wozniak-works/entropy/hardware/0.4-w/keyboard.kicad_sch

## KiCad design hardware/0.4-w/keyboard.kicad_sch (2022-02-18)

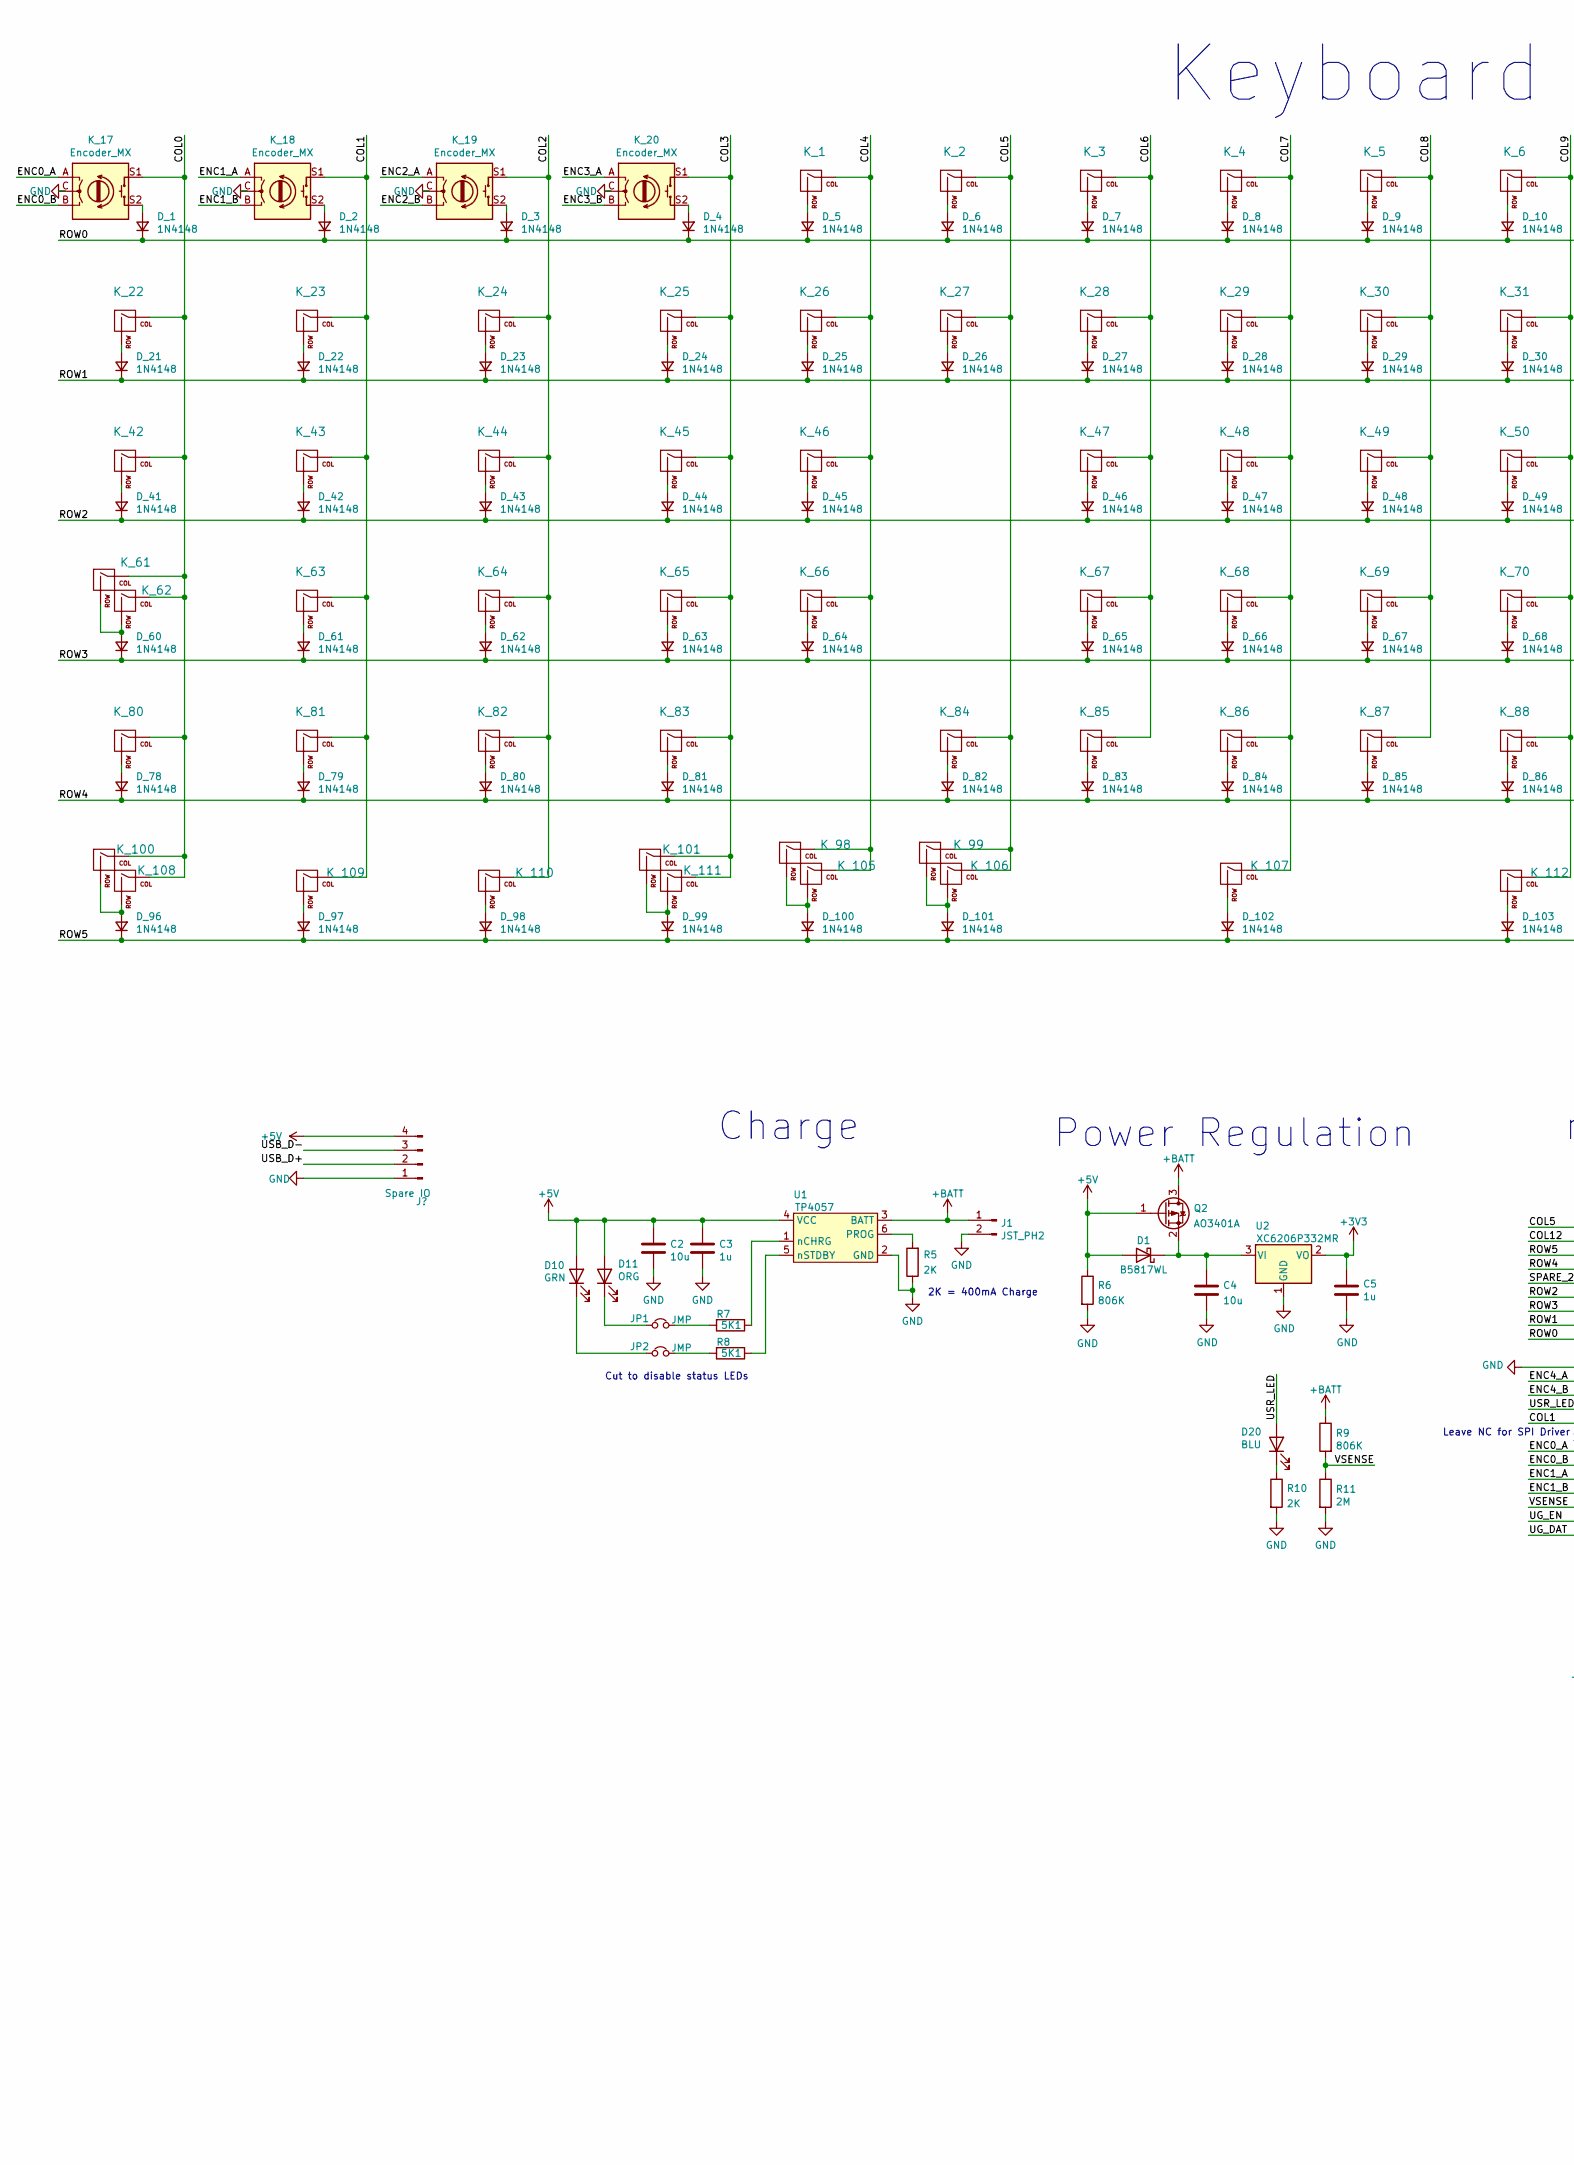
[picture p1: schematic keyboard.kicad_sch, part in row 1, column 1]

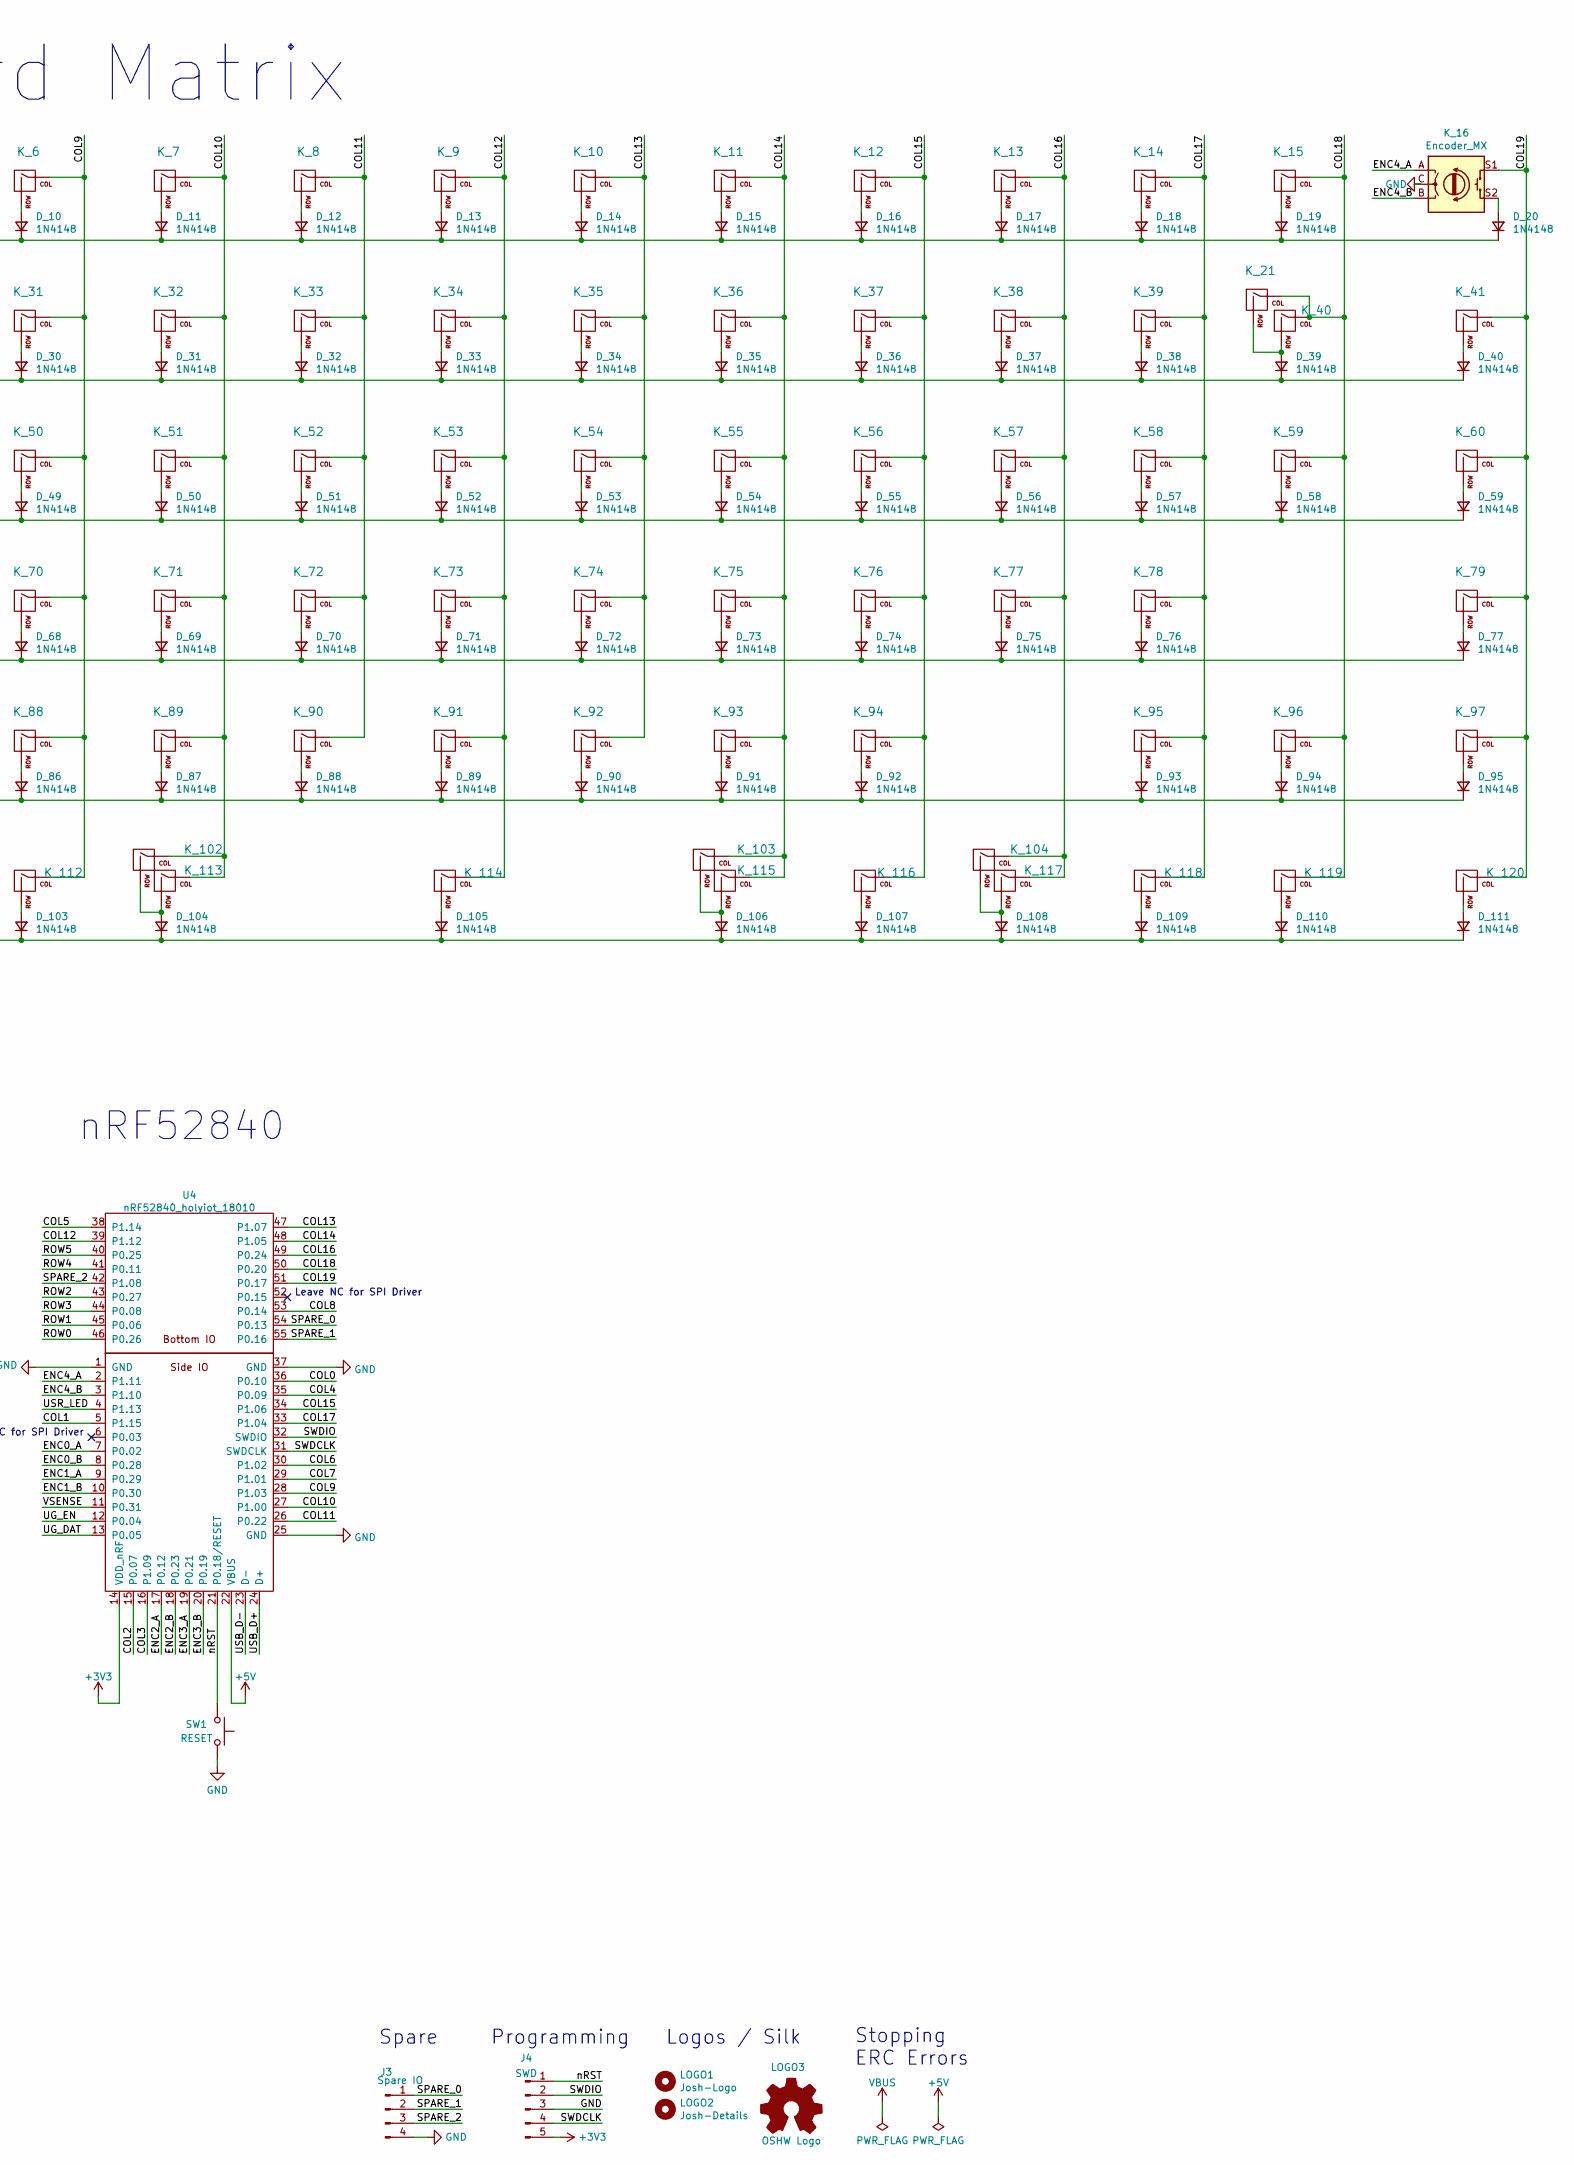
[picture p2: schematic keyboard.kicad_sch, part in row 1, column 2]

Parts:
C2, C4: 10u; C_0603_1608Metric; MPN CL10A106KP8NNNC; JLCSMT C19702
C3: 1u; C_0603_1608Metric; MPN CL10A105KB8NNNC; JLCSMT C15849
C5: 1u; C_0603_1608Metric; MPN CL10A105KB8NNNC; LCSC C15849
D1: B5817WL; D_SOD-123FL; MPN B5817WL; JLCSMT C122853
D10: GRN; LED_0603_1608Metric; MPN 19-217/GHC-YR1S2/3T; JLCSMT C72043
D11: ORG; LED_0603_1608Metric; MPN KT-0603R; JLCSMT C2286
D20: BLU; LED_0603_1608Metric; MPN 19-217/BHC-ZL1M2RY/3T; JLCSMT C72041
D_1, D_2, D_3, D_4, D_5, D_6, D_7, D_8, D_9, D_10, D_11, D_12, D_13, D_14, D_15, D_16, D_17, D_18, D_19, D_20, D_21, D_22, D_23, D_24, D_25, D_26, D_27, D_28, D_29, D_30, D_31, D_32, D_33, D_34, D_35, D_36, D_37, D_38, D_39, D_40, D_41, D_42, D_43, D_44, D_45, D_46, D_47, D_48, D_49, D_50, D_51, D_52, D_53, D_54, D_55, D_56, D_57, D_58, D_59, D_60, D_61, D_62, D_63, D_64, D_65, D_66, D_67, D_68, D_69, D_70, D_71, D_72, D_73, D_74, D_75, D_76, D_77, D_78, D_79, D_80, D_81, D_82, D_83, D_84, D_85, D_86, D_87, D_88, D_89, D_90, D_91, D_92, D_93, D_94, D_95, D_96, D_97, D_98, D_99, D_100, D_101, D_102, D_103, D_104, D_105, D_106, D_107, D_108, D_109, D_110, D_111: 1N4148; D_SOD-123; MPN 1N4148W; JLCSMT C81598
J1: JST_PH2; JST_PH_S2B-PH-SM4-TB_1x02-1MP_P2.00mm_Horizontal; MPN C47647; JLCSMT C47647
J3: Spare IO; 4_PIN_THT_Staggered
J4: SWD; 5_PIN_THT_Staggered
JP1, JP2: JMP; SolderJumper-2_P1.3mm_Bridged_RoundedPad1.0x1.5mm
K_1, K_2, K_3, K_4, K_5, K_6, K_7, K_8, K_9, K_10, K_11, K_12, K_13, K_14, K_15, K_21, K_22, K_23, K_24, K_25, K_26, K_27, K_28, K_29, K_30, K_31, K_32, K_33, K_34, K_35, K_36, K_37, K_38, K_39, K_41, K_42, K_43, K_44, K_47, K_48, K_49, K_50, K_51, K_52, K_53, K_54, K_55, K_56, K_57, K_58, K_60, K_61, K_63, K_64, K_67, K_68, K_69, K_70, K_71, K_72, K_73, K_74, K_75, K_76, K_77, K_79, K_80, K_81, K_82, K_83, K_85, K_86, K_87, K_88, K_89, K_90, K_91, K_92, K_93, K_94, K_96, K_97, K_99, K_100, K_101, K_103, K_104, K_109, K_110, K_116, K_118, K_119, K_120: KEYSW; MXOnly-1U-NoLED
K_16, K_17, K_18, K_19, K_20: Encoder_MX; MX_KEYSWITCH_ENCODER
K_40, K_62, K_108, K_111: KEYSW; MXOnly-2U-NoLED
K_45, K_65: KEYSW; MXOnly-1U-NoLED-3PIN
K_46: KEYSW; MXOnly-1.5U-NoLED-3PIN
K_59, K_98, K_115, K_117: KEYSW; MXOnly-1.5U-NoLED
K_66: KEYSW; MXOnly-1.75U-NoLED-3PIN
K_78, K_84, K_114: KEYSW; MXOnly-2.25U-NoLED
K_95: KEYSW; MXOnly-1.75U-NoLED
K_102, K_105, K_106, K_107: KEYSW; MXOnly-1.25U-NoLED
K_112: KEYSW; MXOnly-2.75U-NoLED
K_113: KEYSW; MXOnly-6.25U-NoLED
LOGO1: Josh-Logo; josh-johnson-logo-17x3
LOGO2: Josh-Details; josh-details
LOGO3: OSHW Logo; OSHW_Logo_3.6x3.6_F.Mask
Q2: AO3401A; SOT-23; MPN AO3401A; JLCSMT C15127
R5, R10: 2K; R_0603_1608Metric
R6, R9: 806K; R_0603_1608Metric; MPN 0603WAF8063T5E; JLCSMT C23250
R7, R8: 5K1; R_0603_1608Metric; MPN 0603WAF5101T5E; JLCSMT C23186
R11: 2M; R_0603_1608Metric; MPN 0603WAF2004T5E; JLCSMT C22976
SW1: RESET; SW_Push_KMR2; MPN KMR231GLFS; LCSC C99271
U1: TP4057; SOT-23-6; MPN TP4057-42-SOT26-R; JLCSMT C12044
U2: XC6206P332MR; SOT-23; MPN XC6206P332MR; JLCSMT C5446
U4: nRF52840_holyiot_18010; MPN YJ-18010

Connections:
+3V3: C5.2, J4.5, U2.2 (VO), U4.14 (VDD_nRF)
+5V: C2.1, C3.1, D1.2 (A), D10.2 (A), D11.2 (A), Q2.1 (G), R6.1, U1.4 (VCC), U4.22 (VBUS)
+BATT: J1.1, Q2.3 (D), R9.1, U1.3 (BATT)
COL0: K_17.S1, K_22.1 (COL), K_42.1 (COL), K_61.1 (COL), K_62.1 (COL), K_80.1 (COL), K_100.1 (COL), K_108.1 (COL), U4.36 (P0.10)
COL1: K_18.S1, K_23.1 (COL), K_43.1 (COL), K_63.1 (COL), K_81.1 (COL), K_109.1 (COL), U4.5 (P1.15)
COL2: K_19.S1, K_24.1 (COL), K_44.1 (COL), K_64.1 (COL), K_82.1 (COL), K_110.1 (COL), U4.15 (P0.07)
COL3: K_20.S1, K_25.1 (COL), K_45.1 (COL), K_65.1 (COL), K_83.1 (COL), K_101.1 (COL), K_111.1 (COL), U4.16 (P1.09)
COL4: K_1.1 (COL), K_26.1 (COL), K_46.1 (COL), K_66.1 (COL), K_98.1 (COL), K_105.1 (COL), U4.35 (P0.09)
COL5: K_2.1 (COL), K_27.1 (COL), K_84.1 (COL), K_99.1 (COL), K_106.1 (COL), U4.38 (P1.14)
COL6: K_3.1 (COL), K_28.1 (COL), K_47.1 (COL), K_67.1 (COL), K_85.1 (COL), U4.30 (P1.02)
COL7: K_4.1 (COL), K_29.1 (COL), K_48.1 (COL), K_68.1 (COL), K_86.1 (COL), K_107.1 (COL), U4.29 (P1.01)
COL8: K_5.1 (COL), K_30.1 (COL), K_49.1 (COL), K_69.1 (COL), K_87.1 (COL), U4.53 (P0.14)
COL9: K_6.1 (COL), K_31.1 (COL), K_50.1 (COL), K_70.1 (COL), K_88.1 (COL), K_112.1 (COL), U4.28 (P1.03)
COL10: K_7.1 (COL), K_32.1 (COL), K_51.1 (COL), K_71.1 (COL), K_89.1 (COL), K_102.1 (COL), K_113.1 (COL), U4.27 (P1.00)
COL11: K_8.1 (COL), K_33.1 (COL), K_52.1 (COL), K_72.1 (COL), K_90.1 (COL), U4.26 (P0.22)
COL12: K_9.1 (COL), K_34.1 (COL), K_53.1 (COL), K_73.1 (COL), K_91.1 (COL), K_114.1 (COL), U4.39 (P1.12)
COL13: K_10.1 (COL), K_35.1 (COL), K_54.1 (COL), K_74.1 (COL), K_92.1 (COL), U4.47 (P1.07)
COL14: K_11.1 (COL), K_36.1 (COL), K_55.1 (COL), K_75.1 (COL), K_93.1 (COL), K_103.1 (COL), K_115.1 (COL), U4.48 (P1.05)
COL15: K_12.1 (COL), K_37.1 (COL), K_56.1 (COL), K_76.1 (COL), K_94.1 (COL), K_116.1 (COL), U4.34 (P1.06)
COL16: K_13.1 (COL), K_38.1 (COL), K_57.1 (COL), K_77.1 (COL), K_104.1 (COL), K_117.1 (COL), U4.49 (P0.24)
COL17: K_14.1 (COL), K_39.1 (COL), K_58.1 (COL), K_78.1 (COL), K_95.1 (COL), K_118.1 (COL), U4.33 (P1.04)
COL18: K_15.1 (COL), K_21.1 (COL), K_40.1 (COL), K_59.1 (COL), K_96.1 (COL), K_119.1 (COL), U4.50 (P0.20)
COL19: K_16.S1, K_41.1 (COL), K_60.1 (COL), K_79.1 (COL), K_97.1 (COL), K_120.1 (COL), U4.51 (P0.17)
ENC0_A: K_17.A, U4.7 (P0.02)
ENC0_B: K_17.B, U4.8 (P0.28)
ENC1_A: K_18.A, U4.9 (P0.29)
ENC1_B: K_18.B, U4.10 (P0.30)
ENC2_A: K_19.A, U4.17 (P0.12)
ENC2_B: K_19.B, U4.18 (P0.23)
ENC3_A: K_20.A, U4.19 (P0.21)
ENC3_B: K_20.B, U4.20 (P0.19)
ENC4_A: K_16.A, U4.2 (P1.11)
ENC4_B: K_16.B, U4.3 (P1.10)
GND: C2.2, C3.2, C4.2, C5.1, J1.2, J3.4, J4.3, K_16.C, K_17.C, K_18.C, K_19.C, K_20.C, R5.1, R6.2, R10.2, R11.2, SW1.2, U1.2 (GND), U2.1 (GND), U4.1 (GND), U4.25 (GND), U4.37 (GND)
unnamed: C4.1, D1.1 (K), Q2.2 (S), U2.3 (VI)
unnamed: D10.1 (K), JP2.1
unnamed: D11.1 (K), JP1.1
unnamed: D20.1 (K), R10.1
unnamed: D_1.2 (A), K_17.S2
unnamed: D_2.2 (A), K_18.S2
unnamed: D_3.2 (A), K_19.S2
unnamed: D_4.2 (A), K_20.S2
unnamed: D_5.2 (A), K_1.2 (ROW)
unnamed: D_6.2 (A), K_2.2 (ROW)
unnamed: D_7.2 (A), K_3.2 (ROW)
unnamed: D_8.2 (A), K_4.2 (ROW)
unnamed: D_9.2 (A), K_5.2 (ROW)
unnamed: D_10.2 (A), K_6.2 (ROW)
unnamed: D_11.2 (A), K_7.2 (ROW)
unnamed: D_12.2 (A), K_8.2 (ROW)
unnamed: D_13.2 (A), K_9.2 (ROW)
unnamed: D_14.2 (A), K_10.2 (ROW)
unnamed: D_15.2 (A), K_11.2 (ROW)
unnamed: D_16.2 (A), K_12.2 (ROW)
unnamed: D_17.2 (A), K_13.2 (ROW)
unnamed: D_18.2 (A), K_14.2 (ROW)
unnamed: D_19.2 (A), K_15.2 (ROW)
unnamed: D_20.2 (A), K_16.S2
unnamed: D_21.2 (A), K_22.2 (ROW)
unnamed: D_22.2 (A), K_23.2 (ROW)
unnamed: D_23.2 (A), K_24.2 (ROW)
unnamed: D_24.2 (A), K_25.2 (ROW)
unnamed: D_25.2 (A), K_26.2 (ROW)
unnamed: D_26.2 (A), K_27.2 (ROW)
unnamed: D_27.2 (A), K_28.2 (ROW)
unnamed: D_28.2 (A), K_29.2 (ROW)
unnamed: D_29.2 (A), K_30.2 (ROW)
unnamed: D_30.2 (A), K_31.2 (ROW)
unnamed: D_31.2 (A), K_32.2 (ROW)
unnamed: D_32.2 (A), K_33.2 (ROW)
unnamed: D_33.2 (A), K_34.2 (ROW)
unnamed: D_34.2 (A), K_35.2 (ROW)
unnamed: D_35.2 (A), K_36.2 (ROW)
unnamed: D_36.2 (A), K_37.2 (ROW)
unnamed: D_37.2 (A), K_38.2 (ROW)
unnamed: D_38.2 (A), K_39.2 (ROW)
unnamed: D_39.2 (A), K_21.2 (ROW), K_40.2 (ROW)
unnamed: D_40.2 (A), K_41.2 (ROW)
unnamed: D_41.2 (A), K_42.2 (ROW)
unnamed: D_42.2 (A), K_43.2 (ROW)
unnamed: D_43.2 (A), K_44.2 (ROW)
unnamed: D_44.2 (A), K_45.2 (ROW)
unnamed: D_45.2 (A), K_46.2 (ROW)
unnamed: D_46.2 (A), K_47.2 (ROW)
unnamed: D_47.2 (A), K_48.2 (ROW)
unnamed: D_48.2 (A), K_49.2 (ROW)
unnamed: D_49.2 (A), K_50.2 (ROW)
unnamed: D_50.2 (A), K_51.2 (ROW)
unnamed: D_51.2 (A), K_52.2 (ROW)
unnamed: D_52.2 (A), K_53.2 (ROW)
unnamed: D_53.2 (A), K_54.2 (ROW)
unnamed: D_54.2 (A), K_55.2 (ROW)
unnamed: D_55.2 (A), K_56.2 (ROW)
unnamed: D_56.2 (A), K_57.2 (ROW)
unnamed: D_57.2 (A), K_58.2 (ROW)
unnamed: D_58.2 (A), K_59.2 (ROW)
unnamed: D_59.2 (A), K_60.2 (ROW)
unnamed: D_60.2 (A), K_61.2 (ROW), K_62.2 (ROW)
unnamed: D_61.2 (A), K_63.2 (ROW)
unnamed: D_62.2 (A), K_64.2 (ROW)
unnamed: D_63.2 (A), K_65.2 (ROW)
unnamed: D_64.2 (A), K_66.2 (ROW)
unnamed: D_65.2 (A), K_67.2 (ROW)
unnamed: D_66.2 (A), K_68.2 (ROW)
unnamed: D_67.2 (A), K_69.2 (ROW)
unnamed: D_68.2 (A), K_70.2 (ROW)
unnamed: D_69.2 (A), K_71.2 (ROW)
unnamed: D_70.2 (A), K_72.2 (ROW)
unnamed: D_71.2 (A), K_73.2 (ROW)
unnamed: D_72.2 (A), K_74.2 (ROW)
unnamed: D_73.2 (A), K_75.2 (ROW)
unnamed: D_74.2 (A), K_76.2 (ROW)
unnamed: D_75.2 (A), K_77.2 (ROW)
unnamed: D_76.2 (A), K_78.2 (ROW)
unnamed: D_77.2 (A), K_79.2 (ROW)
unnamed: D_78.2 (A), K_80.2 (ROW)
unnamed: D_79.2 (A), K_81.2 (ROW)
unnamed: D_80.2 (A), K_82.2 (ROW)
unnamed: D_81.2 (A), K_83.2 (ROW)
unnamed: D_82.2 (A), K_84.2 (ROW)
unnamed: D_83.2 (A), K_85.2 (ROW)
unnamed: D_84.2 (A), K_86.2 (ROW)
unnamed: D_85.2 (A), K_87.2 (ROW)
unnamed: D_86.2 (A), K_88.2 (ROW)
unnamed: D_87.2 (A), K_89.2 (ROW)
unnamed: D_88.2 (A), K_90.2 (ROW)
unnamed: D_89.2 (A), K_91.2 (ROW)
unnamed: D_90.2 (A), K_92.2 (ROW)
unnamed: D_91.2 (A), K_93.2 (ROW)
unnamed: D_92.2 (A), K_94.2 (ROW)
unnamed: D_93.2 (A), K_95.2 (ROW)
unnamed: D_94.2 (A), K_96.2 (ROW)
unnamed: D_95.2 (A), K_97.2 (ROW)
unnamed: D_96.2 (A), K_100.2 (ROW), K_108.2 (ROW)
unnamed: D_97.2 (A), K_109.2 (ROW)
unnamed: D_98.2 (A), K_110.2 (ROW)
unnamed: D_99.2 (A), K_101.2 (ROW), K_111.2 (ROW)
unnamed: D_100.2 (A), K_98.2 (ROW), K_105.2 (ROW)
unnamed: D_101.2 (A), K_99.2 (ROW), K_106.2 (ROW)
unnamed: D_102.2 (A), K_107.2 (ROW)
unnamed: D_103.2 (A), K_112.2 (ROW)
unnamed: D_104.2 (A), K_102.2 (ROW), K_113.2 (ROW)
unnamed: D_105.2 (A), K_114.2 (ROW)
unnamed: D_106.2 (A), K_103.2 (ROW), K_115.2 (ROW)
unnamed: D_107.2 (A), K_116.2 (ROW)
unnamed: D_108.2 (A), K_104.2 (ROW), K_117.2 (ROW)
unnamed: D_109.2 (A), K_118.2 (ROW)
unnamed: D_110.2 (A), K_119.2 (ROW)
unnamed: D_111.2 (A), K_120.2 (ROW)
unnamed: JP1.2, R7.2
unnamed: JP2.2, R8.2
unnamed: R5.2, U1.6 (PROG)
unnamed: R7.1, U1.1 (nCHRG)
unnamed: R8.1, U1.5 (nSTDBY)
ROW0: D_1.1 (K), D_2.1 (K), D_3.1 (K), D_4.1 (K), D_5.1 (K), D_6.1 (K), D_7.1 (K), D_8.1 (K), D_9.1 (K), D_10.1 (K), D_11.1 (K), D_12.1 (K), D_13.1 (K), D_14.1 (K), D_15.1 (K), D_16.1 (K), D_17.1 (K), D_18.1 (K), D_19.1 (K), D_20.1 (K), U4.46 (P0.26)
ROW1: D_21.1 (K), D_22.1 (K), D_23.1 (K), D_24.1 (K), D_25.1 (K), D_26.1 (K), D_27.1 (K), D_28.1 (K), D_29.1 (K), D_30.1 (K), D_31.1 (K), D_32.1 (K), D_33.1 (K), D_34.1 (K), D_35.1 (K), D_36.1 (K), D_37.1 (K), D_38.1 (K), D_39.1 (K), D_40.1 (K), U4.45 (P0.06)
ROW2: D_41.1 (K), D_42.1 (K), D_43.1 (K), D_44.1 (K), D_45.1 (K), D_46.1 (K), D_47.1 (K), D_48.1 (K), D_49.1 (K), D_50.1 (K), D_51.1 (K), D_52.1 (K), D_53.1 (K), D_54.1 (K), D_55.1 (K), D_56.1 (K), D_57.1 (K), D_58.1 (K), D_59.1 (K), U4.43 (P0.27)
ROW3: D_60.1 (K), D_61.1 (K), D_62.1 (K), D_63.1 (K), D_64.1 (K), D_65.1 (K), D_66.1 (K), D_67.1 (K), D_68.1 (K), D_69.1 (K), D_70.1 (K), D_71.1 (K), D_72.1 (K), D_73.1 (K), D_74.1 (K), D_75.1 (K), D_76.1 (K), D_77.1 (K), U4.44 (P0.08)
ROW4: D_78.1 (K), D_79.1 (K), D_80.1 (K), D_81.1 (K), D_82.1 (K), D_83.1 (K), D_84.1 (K), D_85.1 (K), D_86.1 (K), D_87.1 (K), D_88.1 (K), D_89.1 (K), D_90.1 (K), D_91.1 (K), D_92.1 (K), D_93.1 (K), D_94.1 (K), D_95.1 (K), U4.41 (P0.11)
ROW5: D_96.1 (K), D_97.1 (K), D_98.1 (K), D_99.1 (K), D_100.1 (K), D_101.1 (K), D_102.1 (K), D_103.1 (K), D_104.1 (K), D_105.1 (K), D_106.1 (K), D_107.1 (K), D_108.1 (K), D_109.1 (K), D_110.1 (K), D_111.1 (K), U4.40 (P0.25)
SPARE_0: J3.1, U4.54 (P0.13)
SPARE_1: J3.2, U4.55 (P0.16)
SPARE_2: J3.3, U4.42 (P1.08)
SWDCLK: J4.4, U4.31 (SWDCLK)
SWDIO: J4.2, U4.32 (SWDIO)
UG_DAT: U4.13 (P0.05)
UG_EN: U4.12 (P0.04)
USB_D+: U4.24 (D+)
USB_D-: U4.23 (D-)
USR_LED: D20.2 (A), U4.4 (P1.13)
VSENSE: R9.2, R11.1, U4.11 (P0.31)
nRST: J4.1, SW1.1, U4.21 (P0.18/RESET)

Notes on the sheet:
Programming
Keyboard Matrix
Charge
Leave NC for SPI Driver
Cut to disable status LEDs
2K = 400mA Charge
Power Regulation
nRF52840
Logos / Silk
Stopping ERC Errors
Spare
