wozniak-works/entropy/(commit log)

2022-02-18 0.4 delete LEDs and traces connected to LED
    [keyboard.kicad_sch]
2022-02-18 0.4 delete USB and add connector to Unified Daughterboard
    [keyboard.kicad_sch]
